xingwenzan/STProjectFiles/README.pdf

## README

# 两栖机器人开发项目

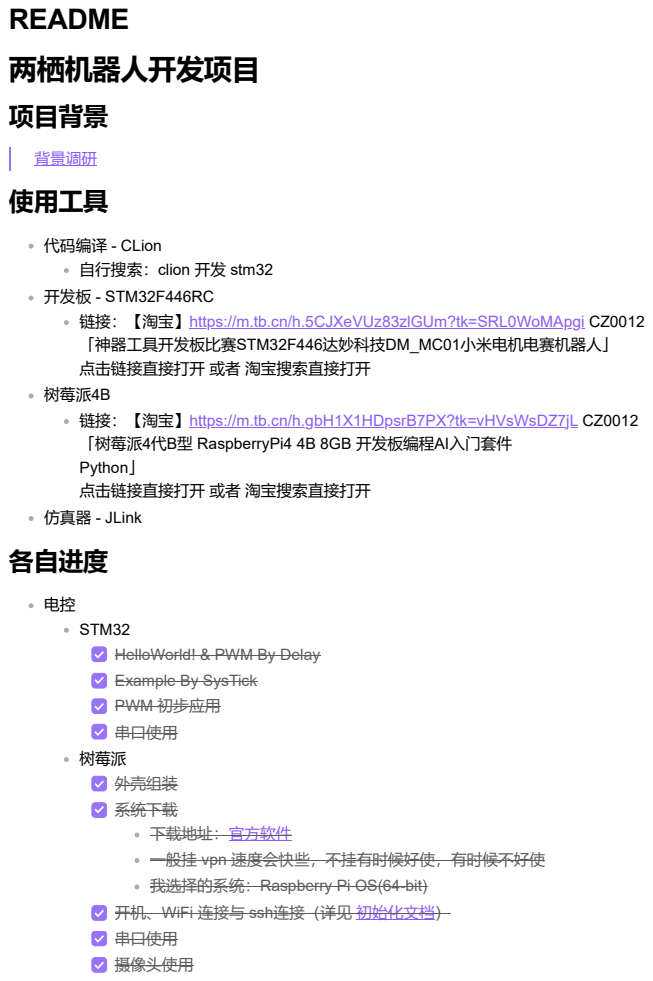
[picture p114: page 1]
项目背景; 背景调研 使用工具

代码编译 - CLion
自行搜索：clion 开发 stm32
开发板 - STM32F446RC
链接：【淘宝】https://m.tb.cn/h.5CJXeVUz83zlGUm?tk=SRL0WoMApgi CZ0012
「神器工具开发板比赛STM32F446达妙科技DM_MC01小米电机电赛机器人」
点击链接直接打开 或者 淘宝搜索直接打开
树莓派4B
链接：【淘宝】https://m.tb.cn/h.gbH1X1HDpsrB7PX?tk=vHVsWsDZ7jL CZ0012
「树莓派4代B型 RaspberryPi4 4B 8GB 开发板编程AI入门套件
Python」
仿真器 - JLink
各自进度

STM32
HelloWorld! & PWM By Delay
Example By SysTick
PWM 初步应用
串口使用
树莓派
外壳组装
系统下载
下载地址：官方软件 (https://downloads.raspberrypi.org/imager/imager_latest.exe)
一般挂 vpn 速度会快些，不挂有时候好使，有时候不好使
我选择的系统：Raspberry Pi OS(64-bit)
开机、WiFi 连接与 ssh连接（详见 初始化文档）
摄像头使用

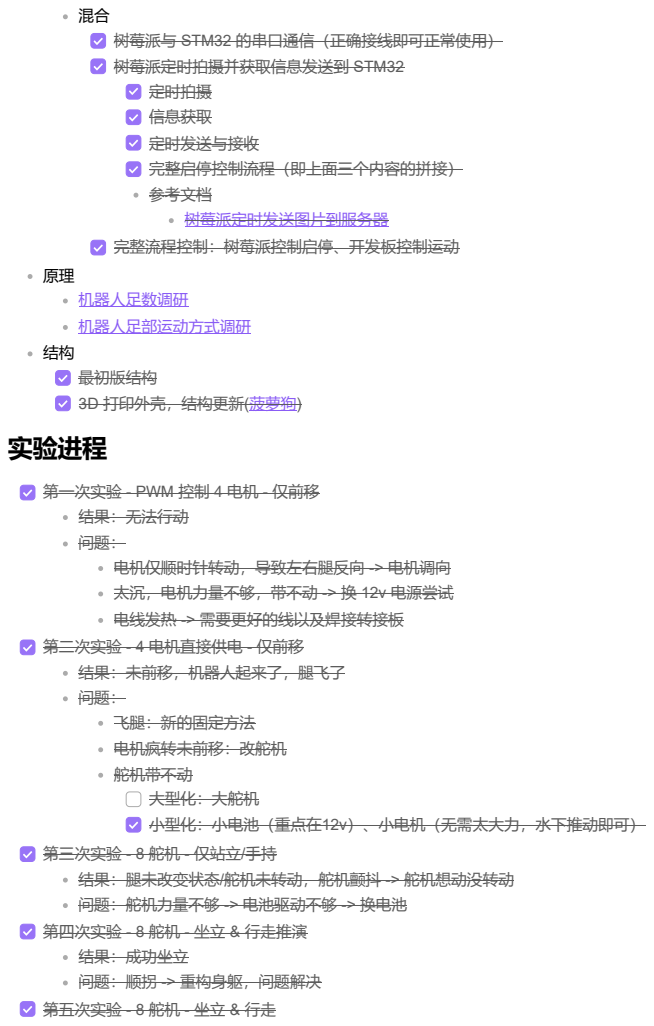
[picture p115: page 2]
实验进程; 树莓派与 STM32 的串口通信（正确接线即可正常使用） 树莓派定时拍摄并获取信息发送到 STM32 定时拍摄 信息获取 定时发送与接收 完整启停控制流程（即上面三个内容的拼接） 参考文档 树莓派定时发送图片到服务器; 机器人足数调研 机器人足部运动方式调研; 最初版结构 3D 打印外壳，结构更新(菠萝狗)

完整流程控制：树莓派控制启停、开发板控制运动

第一次实验 - PWM 控制 4 电机 - 仅前移
结果：无法行动
电机仅顺时针转动，导致左右腿反向 -> 电机调向
太沉，电机力量不够，带不动 -> 换 12v 电源尝试
电线发热 -> 需要更好的线以及焊接转接板

第二次实验 - 4 电机直接供电 - 仅前移
结果：未前移，机器人起来了，腿飞了
飞腿：新的固定方法
电机疯转未前移：改舵机
舵机带不动
大型化：大舵机
小型化：小电池（重点在12v）、小电机（无需太大力，水下推动即可）

第三次实验 - 8 舵机 - 仅站立/手持
结果：腿未改变状态/舵机未转动，舵机颤抖 -> 舵机想动没转动
问题：舵机力量不够 -> 电池驱动不够 -> 换电池
第四次实验 - 8 舵机 - 坐立 & 行走推演
结果：成功坐立
问题：顺拐 -> 重构身躯，问题解决
第五次实验 - 8 舵机 - 坐立 & 行走

# 相关资料

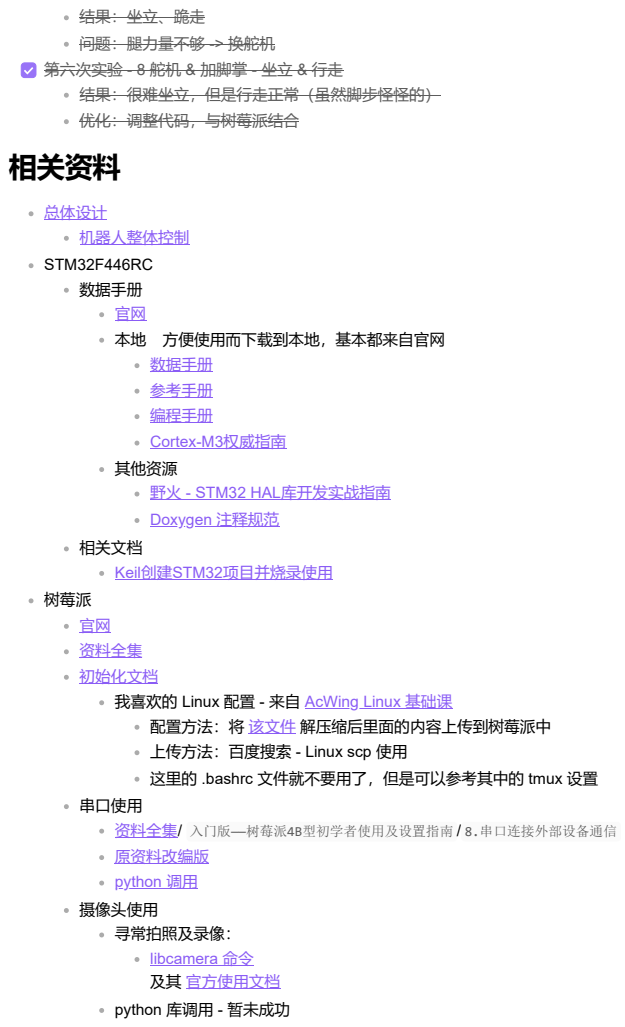
[picture p116: page 3]
总体设计 机器人整体控制; STM32F446RC 数据手册 官网 本地 方便使用而下载到本地，基本都来自官网 数据手册 参考手册 编程手册; Cortex-M3权威指南 其他资源 野火 - STM32 HAL库开发实战指南; Doxygen 注释规范; 相关文档 Keil创建STM32项目并烧录使用

问题：腿力量不够 -> 换舵机
第六次实验 - 8 舵机 & 加脚掌 - 坐立 & 行走
结果：很难坐立，但是行走正常（虽然脚步怪怪的）
优化：调整代码，与树莓派结合

树莓派
资料全集 (https://pan.baidu.com/s/1SkvnrBC5YwOKgMn1FnPlzw?pwd=mylo)
初始化文档
我喜欢的 Linux 配置 - 来自 AcWing Linux 基础课 (https://www.acwing.com/activity/content/57/)
配置方法：将 该文件 解压缩后里面的内容上传到树莓派中
上传方法：百度搜索 - Linux scp 使用
这里的 .bashrc 文件就不要用了，但是可以参考其中的 tmux 设置

串口使用
资料全集/ (https://pan.baidu.com/s/1SkvnrBC5YwOKgMn1FnPlzw?pwd=mylo) 入门版——树莓派4B型初学者使用及设置指南 / 8.串口连接外部设备通信
原资料改编版
python 调用 (https://blog.csdn.net/ZhuanShangNiDeXin/article/details/113791267)
摄像头使用
寻常拍照及录像：
libcamera 命令 (https://shumeipai.nxez.com/2023/05/14/camera-module-v3-configuration-and-libcamera-usage.html)
及其 官方使用文档 (https://www.raspberrypi.com/documentation/computers/camera_software.html)
python 库调用 - 暂未成功

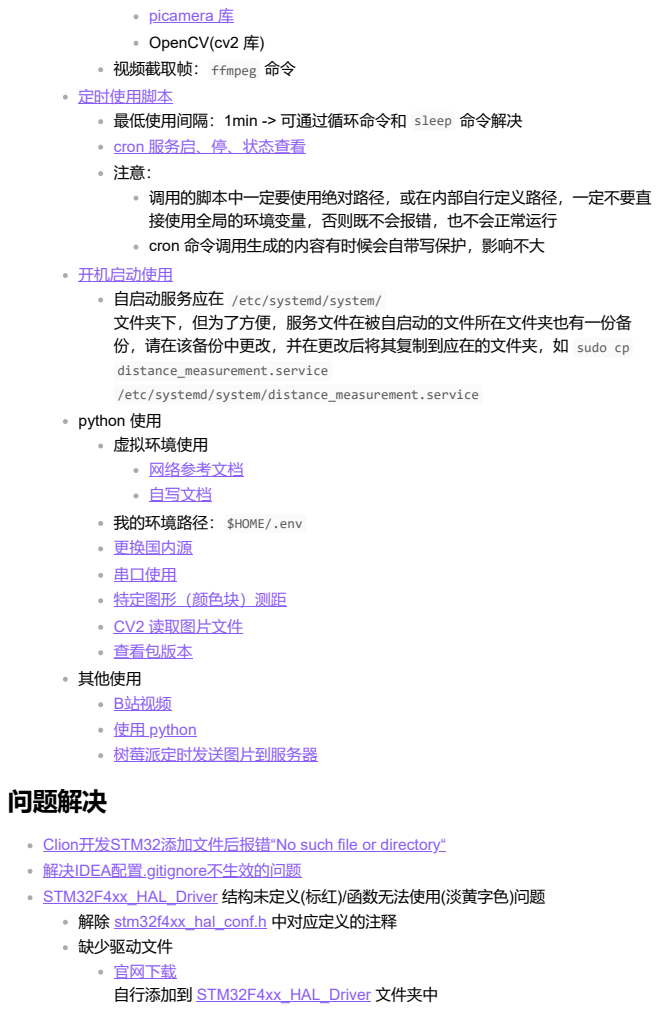
[picture p117: page 4]
问题解决

picamera 库 (https://blog.csdn.net/yong1585855343/article/details/121762202)
OpenCV(cv2 库)
视频截取帧： ffmpeg 命令
定时使用脚本 (https://www.labno3.com/2021/08/05/raspberry-pi-time-lapse-in-four-easy-steps/#i-8)
最低使用间隔：1min -> 可通过循环命令和 sleep 命令解决
cron 服务启、停、状态查看 (https://www.jianshu.com/p/7cc20d441bda)
调用的脚本中一定要使用绝对路径，或在内部自行定义路径，一定不要直
接使用全局的环境变量，否则既不会报错，也不会正常运行
cron 命令调用生成的内容有时候会自带写保护，影响不大

开机启动使用 (https://shumeipai.nxez.com/2020/06/30/linux-usage-systemd.html)
自启动服务应在 /etc/systemd/system/
文件夹下，但为了方便，服务文件在被自启动的文件所在文件夹也有一份备
份，请在该备份中更改，并在更改后将其复制到应在的文件夹，如 sudo cp
distance_measurement.service
/etc/systemd/system/distance_measurement.service
python 使用
虚拟环境使用
网络参考文档 (https://blog.csdn.net/qq_59449692/article/details/136397131)
自写文档
我的环境路径： $HOME/.env
更换国内源 (https://blog.csdn.net/qq_44214671/article/details/111008427)
串口使用 (https://blog.csdn.net/ZhuanShangNiDeXin/article/details/113791267)
特定图形（颜色块）测距 (https://blog.csdn.net/qq_42444944/article/details/97415276)
CV2 读取图片文件 (https://blog.csdn.net/weixin_43196262/article/details/82807698)
查看包版本 (https://blog.csdn.net/weixin_42578378/article/details/89293537)
其他使用
B站视频 (https://www.bilibili.com/video/BV1QB4y1M7EJ/?buvid=XU8906089F0C5E86A9676712E0A07656645F7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)
使用 python (https://blog.csdn.net/Eden2088/article/details/122118962)
树莓派定时发送图片到服务器 (https://www.cnblogs.com/nnnv/p/17722550.html)

Clion开发STM32添加文件后报错“No such file or directory“ (https://blog.csdn.net/weixin_45636061/article/details/121623826)
解决IDEA配置.gitignore不生效的问题 (https://blog.csdn.net/qq_43705131/article/details/107989768)
STM32F4xx_HAL_Driver 结构未定义(标红)/函数无法使用(淡黄字色)问题
解除 stm32f4xx_hal_conf.h 中对应定义的注释
缺少驱动文件
官网下载 (https://www.st.com/zh/embedded-software/stm32cubef4.html)
自行添加到 STM32F4xx_HAL_Driver 文件夹中

备注

系统时钟问题 (https://blog.csdn.net/u014670574/article/details/70162036)
树莓派为 py 安装依赖的包时 error: externally-managed-environment (https://www.yaolong.net/article/pip-externally-managed-environment/) 树莓派使用 pip 安装太慢解决 (https://blog.csdn.net/qq_43556844/article/details/113616214)
树莓派 py 使用串口不好使 (https://blog.csdn.net/ChenWenHaoHaoHao/article/details/130328922)

自写代码添加到 Users 文件夹中使用
