xingwenzan/STProjectFiles/(list of files, drawings)

Other design files:
RelevantInformation/ExpansionBoard/exBoard_2.eprj
RelevantInformation/ExpansionBoard/exBoard_3.eprj
RelevantInformation/ExpansionBoard/exBoard_4.eprj
