xingwenzan/STProjectFiles/Core/Src/main.c

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
/* Includes ------------------------------------------------------------------*/
#include "main.h"
/* USER CODE BEGIN Includes */
#include "myGpio.h"
#include "myTIM.h"
#include "myUsart.h"
#include "myRobot.h"
#include "BMI088driver.h"
#include "myIMU.h"
/* USER CODE END Includes */


/* USER CODE BEGIN PV */
uint16_t walk = 0;   // walk 赋值，该参数是 extern 型变量，可以在同一个项目中跨文件使用
uint8_t walk_state = 2;  // walk_state 赋值，该参数是 extern 型变量，可以在同一个项目中跨文件使用
uint8_t walk_sign = 0;

/* USER CODE END PV */

void SystemClock_Config(void);

/* USER CODE BEGIN 0 */

// IMU 获取数据
fp32 gyro[3] = {0}, accel[3] = {0}, temp = 0;
fp32 pitch = 0; // 俯仰角
fp32 roll = 0; // 横滚角

/* USER CODE END 0 */

/**
  * @brief  The application entry point.
  * @retval int
  */
int main(void) {

    /* MCU Configuration--------------------------------------------------------*/

    /* Reset of all peripherals, Initializes the Flash interface and the Systick. */
    HAL_Init();

    /* Configure the system clock */
    SystemClock_Config();

    /* Initialize all configured peripherals */
    /* USER CODE BEGIN 2 */
    // 初始?? LED
    MY_LED_GPIO_CLK_ENABLE();   // LED（C 端口）时钟使能，使用外设时都要先开启它的时钟，且端口时钟使能后才能进行初始化
    MY_GPIO_INIT(MY_LED_GPIO_PORT, MY_LED_PIN);   // 初始化 LED 引脚
    HAL_GPIO_WritePin(MY_LED_GPIO_PORT, MY_LED_PIN, GPIO_PIN_SET);
    // 机器人初始化
    Robot_Init();   // 机器人初始化函数
    // 其他功能
    TIMx_Configuration();   // 初始化基本定时器定时器，控制机器人运动的每一步的核心
    MX_UART_Init();   // 初始化串口
//    HAL_UART_Transmit(&huart, "my Uart Hello!\n", 15, 100);
    // 初始化 IMU
    IMU_Init();

    // IMU 测试用，用于将获取的内容发出到串口
//    union Data_Uart_Float tmp_out = {0};

    /* USER CODE END 2 */

    /* Infinite loop */
    /* USER CODE BEGIN WHILE */
    while (1) {
        /* USER CODE BEGIN 3 */
        if (walk_sign) {
            // IMU 数据读取
            BMI088_read(gyro, accel, &temp);
            GetPitchAndRoll(gyro, accel, &pitch, &roll);
            // 机器狗腿运动
            Robot_Leg_Do(&pitch, &roll);
            walk_sign = 0;

            // 角度测试
//            tmp_out.fx = pitch;
//            Float_Uart_Out(&huart, tmp_out);
//            tmp_out.fx = roll;
//            Float_Uart_Out(&huart, tmp_out);
        }
        /*
        // IMU 测试（数据读取显示）
        // temp
        tmp_out.fx = temp;
        Float_Uart_Out(&huart, tmp_out);
        // accel x,y,z
        for (int i = 0; i < 3; ++i) {
            tmp_out.fx = accel[i];
            Float_Uart_Out(&huart, tmp_out);
        }
        // gyro x,y,z
        for (int i = 0; i < 3; ++i) {
            tmp_out.fx = gyro[i];
            Float_Uart_Out(&huart, tmp_out);
        }
        HAL_Delay(100);
         */


        // 主要信号接收部分，通过接收串口信号实现启停接收
        uint8_t ch = 0;
        if (HAL_UART_Receive(&huart,  &ch, 1, 0) == HAL_OK && walk_state!=ch) {// 串口接收
            HAL_GPIO_TogglePin(MY_LED_GPIO_PORT, MY_LED_PIN);
            walk_state = ch;
        }

        /*
//        // 舵机角度测试
//        if (ch == '=') {
//            Robot_Leg_PWM(tmp);
//            tmp = 0;
//        } else {
//            tmp *= 10;
//            tmp += ch-'0';
//        }
         */

        /* USER CODE END 3 */
    }
    /* USER CODE END WHILE */
}

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
