xingwenzan/STProjectFiles/STProjectFiles.ioc

Mcu.UserName=STM32F446RCTx
PA11.Signal=USB_OTG_FS_DM
PA12.Signal=USB_OTG_FS_DP
PA13.Signal=SYS_JTMS-SWDIO
PA14.Signal=SYS_JTCK-SWCLK
PB0.GPIO_Label=SPI2_Gyro_CS
PB0.Signal=GPIO_Output
PB1.GPIO_Label=SPI2_Accel_CS
PB1.Signal=GPIO_Output
PB10.Signal=SPI2_SCK
PB14.Signal=SPI2_MISO
PB15.Signal=SPI2_MOSI
PB5.Signal=S_TIM3_CH2
PC2.GPIO_Label=Accel_INT
PC2.Signal=GPIO_Input
PC3.GPIO_Label=Gryo_INT
PC3.Signal=GPIO_Input
PH0-OSC_IN.Signal=RCC_OSC_IN
PH1-OSC_OUT.Signal=RCC_OSC_OUT
