xingwenzan/STProjectFiles/Core/Inc/main.h

#define Accel_INT_Pin GPIO_PIN_2
#define Accel_INT_GPIO_Port GPIOC
#define Gryo_INT_Pin GPIO_PIN_3
#define Gryo_INT_GPIO_Port GPIOC
#define SPI2_Gyro_CS_Pin GPIO_PIN_0
#define SPI2_Gyro_CS_GPIO_Port GPIOB
#define SPI2_Accel_CS_Pin GPIO_PIN_1
#define SPI2_Accel_CS_GPIO_Port GPIOB
