xingwenzan/STProjectFiles/Users/Inc/mySpi.h

/**
  ******************************************************************************
  * File Name          : SPI.h
  * Description        : This file provides code for the configuration
  *                      of the SPI instances.
  ******************************************************************************
  * @attention
  *
  * <h2><center>&copy; Copyright (c) 2025 STMicroelectronics.
  * All rights reserved.</center></h2>
  *
  * This software component is licensed by ST under Ultimate Liberty license
  * SLA0044, the "License"; You may not use this file except in compliance with
  * the License. You may obtain a copy of the License at:
  *                             www.st.com/SLA0044
  *
  ******************************************************************************
  */
/* Define to prevent recursive inclusion -------------------------------------*/
#ifndef __spi_H
#define __spi_H
#ifdef __cplusplus
extern "C" {
#endif

/* Includes ------------------------------------------------------------------*/
#include "main.h"

/* USER CODE BEGIN Includes */
#define SPI2_Gyro_CS_Pin GPIO_PIN_0
#define SPI2_Gyro_CS_GPIO_Port GPIOB
#define SPI2_Accel_CS_Pin GPIO_PIN_1
#define SPI2_Accel_CS_GPIO_Port GPIOB
#define SPI2_AccelAndGyro_CS_GPIO_CLK_ENABLE() __HAL_RCC_GPIOB_CLK_ENABLE()
/* USER CODE END Includes */

extern SPI_HandleTypeDef hspi2;

void MX_SPI2_Init(void);

#ifdef __cplusplus
}
#endif
#endif /*__spi_H */

/**
  * @}
  */

/**
  * @}
  */

/************************ (C) COPYRIGHT STMicroelectronics *****END OF FILE****/
