xingwenzan/STProjectFiles/Users/Inc/myUart.h

//
// Created by 86159 on 2024/4/30.
//

#ifndef STPROJECTFILES_MYUART_H
#define STPROJECTFILES_MYUART_H

#include "main.h"

extern UART_HandleTypeDef huart;

void MX_UART_Init(void);

#endif //STPROJECTFILES_MYUART_H
