xingwenzan/STProjectFiles/Users/Src/mySysTick.c

//
// Created by 86159 on 2024-03-29.
//

#include "mySysTick.h"

/**
 * @brief 系统定时器初始化，每 us 微秒中断一次
 * @param us 中断间隔
 */
void MY_SysTick_INIT(uint32_t us) {
    /*
     * SystemFrequency / 1000 1ms中断一次
     * SystemFrequency / 100000 10us中断一次
     * SystemFrequency / 1000000 1us中断一次
     *
     * 下方调用含义：TickNumb 次脉冲中断一次
     *
     * 另：中断行为一律在 stm32f4xx_it.c 内
     * */
    if (HAL_SYSTICK_Config(SystemCoreClock / 1000000 * us)) {
//        while (1);  // Capture error 错误捕获
    }
}
