xingwenzan/STProjectFiles/Users/Inc/mySysTick.h

//
// Created by 86159 on 2024-03-29.
//

#ifndef STPROJECTFILES_MYSYSTICK_H
#define STPROJECTFILES_MYSYSTICK_H

#ifdef __cplusplus
extern "C" {
#endif

#include "main.h"

void MY_SysTick_INIT(uint32_t us);

#ifdef __cplusplus
}
#endif

#endif //STPROJECTFILES_MYSYSTICK_H
