xingwenzan/STProjectFiles/(commit log)

2024-04-09 use PWM successfully
2024-04-25 add Raspberry Pi
2024-04-28 add stm32 uart source
2024-04-29 add stm32 uart
2024-05-03 close stm32 uart
2024-05-03 try steering gear
2024-05-07 Init RaspberryPi
2024-05-10 use uart successfully
2024-05-16 timing camera
2024-05-17 timing camera successfully
2024-05-18 Raspberry Uart by python successfully
2024-06-06 add STM32InitByKeil.md
2024-06-26 add FlowChar
2024-07-07 add uart
2025-01-01 add exBoard
    [exBoard_2.eprj]
2025-01-02 Successfully configured pin function
2025-01-06 Successfully solved the problem of Raspberry Pi virtual environment
2025-01-06 STM32 control update and wait test
2025-01-12 Steering gear angle control test
2025-01-12 Expansion board update
    [exBoard_3.eprj]
2025-01-19 Use IMU and receive by uart
2025-02-11 new exBoard
    [exBoard_4.eprj]
2025-02-16 发现奇怪的bug，流水线存在偏移，该bug未理解，但通过办法掩盖了该bug，使其不影响运动
2025-03-20 ADD IMU
2025-04-07 步态调整
