xingwenzan/STProjectFiles/(notices)

Notices in the files:
Core/Inc/main.h:
Copyright (c) 2024 STMicroelectronics.
All rights reserved.
This software is licensed under terms that can be found in the LICENSE file
